gucio321/EspScope/case/EspScopeCaseV2.FCStd

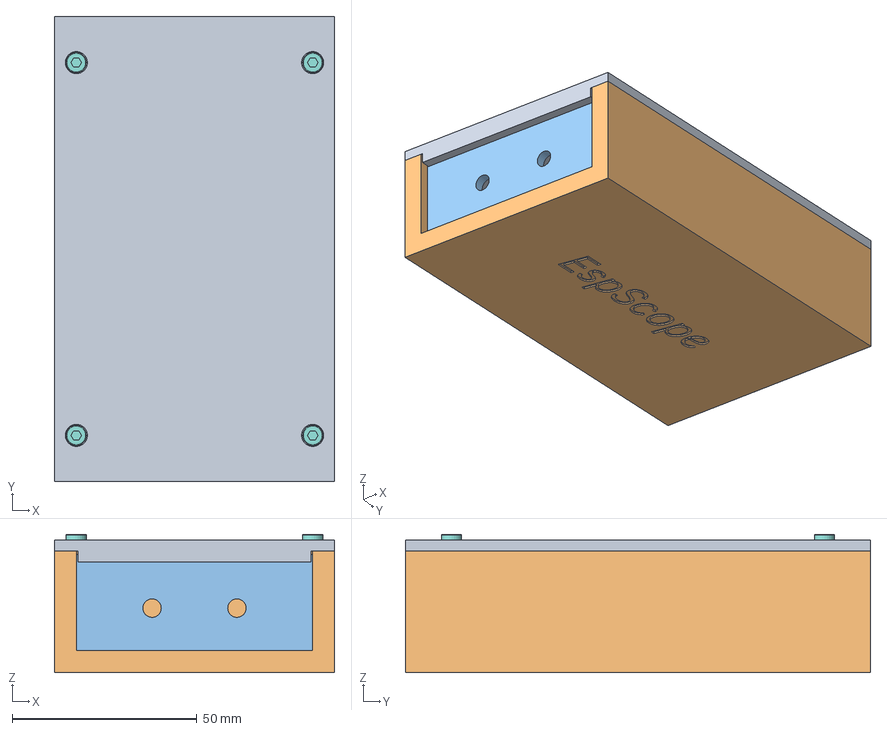
[picture p2: CAD file, 2026-10-28]
case/EspScopeCaseV2.FCStd
76.0 x 126.0 x 37.5 mm
BottomPlate
TopCover
Front
Back
Board~Emqj
TopSilkscreen~Emqj
TopSilkscreen~Emqj001
TopSilkscreen~Emqj002
TopSilkscreen~Emqj003
TopSilkscreen~Emqj004
TopSilkscreen~Emqj005
TopSilkscreen~Emqj006
TopSilkscreen~Emqj007
TopSilkscreen~Emqj008
TopSilkscreen~Emqj009
TopSilkscreen~Emqj010
TopSilkscreen~Emqj011
TopSilkscreen~Emqj012
TopSilkscreen~Emqj013
TopSilkscreen~Emqj014
TopSilkscreen~Emqj015
TopSilkscreen~Emqj016
TopSilkscreen~Emqj017
TopSilkscreen~Emqj018
TopSilkscreen~Emqj019
TopSilkscreen~Emqj020
TopSilkscreen~Emqj021
TopSilkscreen~Emqj022
TopSilkscreen~Emqj023
TopSilkscreen~Emqj024
TopSilkscreen~Emqj025
TopSilkscreen~Emqj026
TopSilkscreen~Emqj027
TopSilkscreen~Emqj028
TopSilkscreen~Emqj029
TopSilkscreen~Emqj030
TopSilkscreen~Emqj031
TopSilkscreen~Emqj032
TopSilkscreen~Emqj033
TopSilkscreen~Emqj034
TopSilkscreen~Emqj035
TopSilkscreen~Emqj036
TopSilkscreen~Emqj037
TopSilkscreen~Emqj038
TopSilkscreen~Emqj039
TopSilkscreen~Emqj040
TopSilkscreen~Emqj041
TopSilkscreen~Emqj042
TopSilkscreen~Emqj043
TopSilkscreen~Emqj044
TopSilkscreen~Emqj045
TopSilkscreen~Emqj046
TopSilkscreen~Emqj047
TopSilkscreen~Emqj048
TopSilkscreen~Emqj049
TopSilkscreen~Emqj050
TopSilkscreen~Emqj051
TopSilkscreen~Emqj052
TopSilkscreen~Emqj053
TopSilkscreen~Emqj054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
