gucio321/EspScope/case/EspScope.FCStd

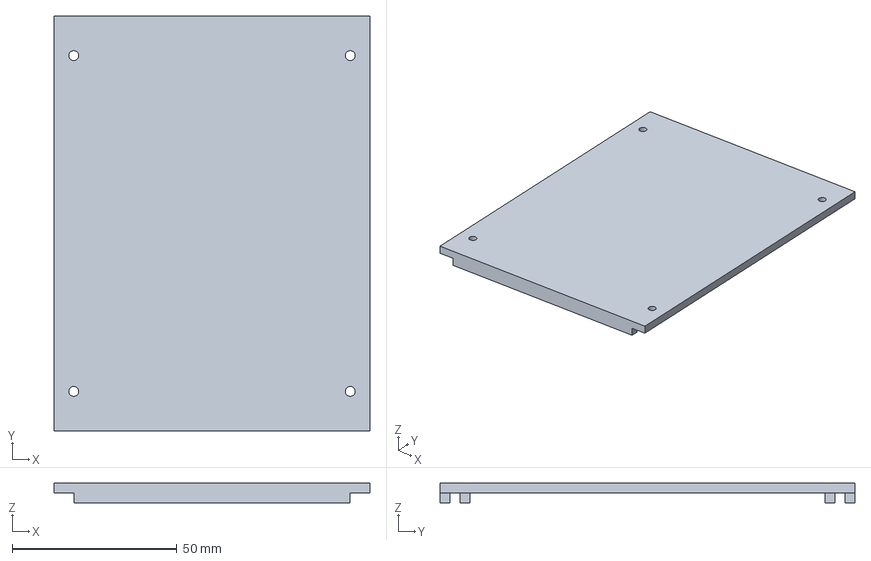
[picture p3: CAD file, 2026-06-23]
case/EspScope.FCStd
96.0 x 126.0 x 6.00 mm
