gucio321/EspScope/PCB/EspScope_schematic.pdf

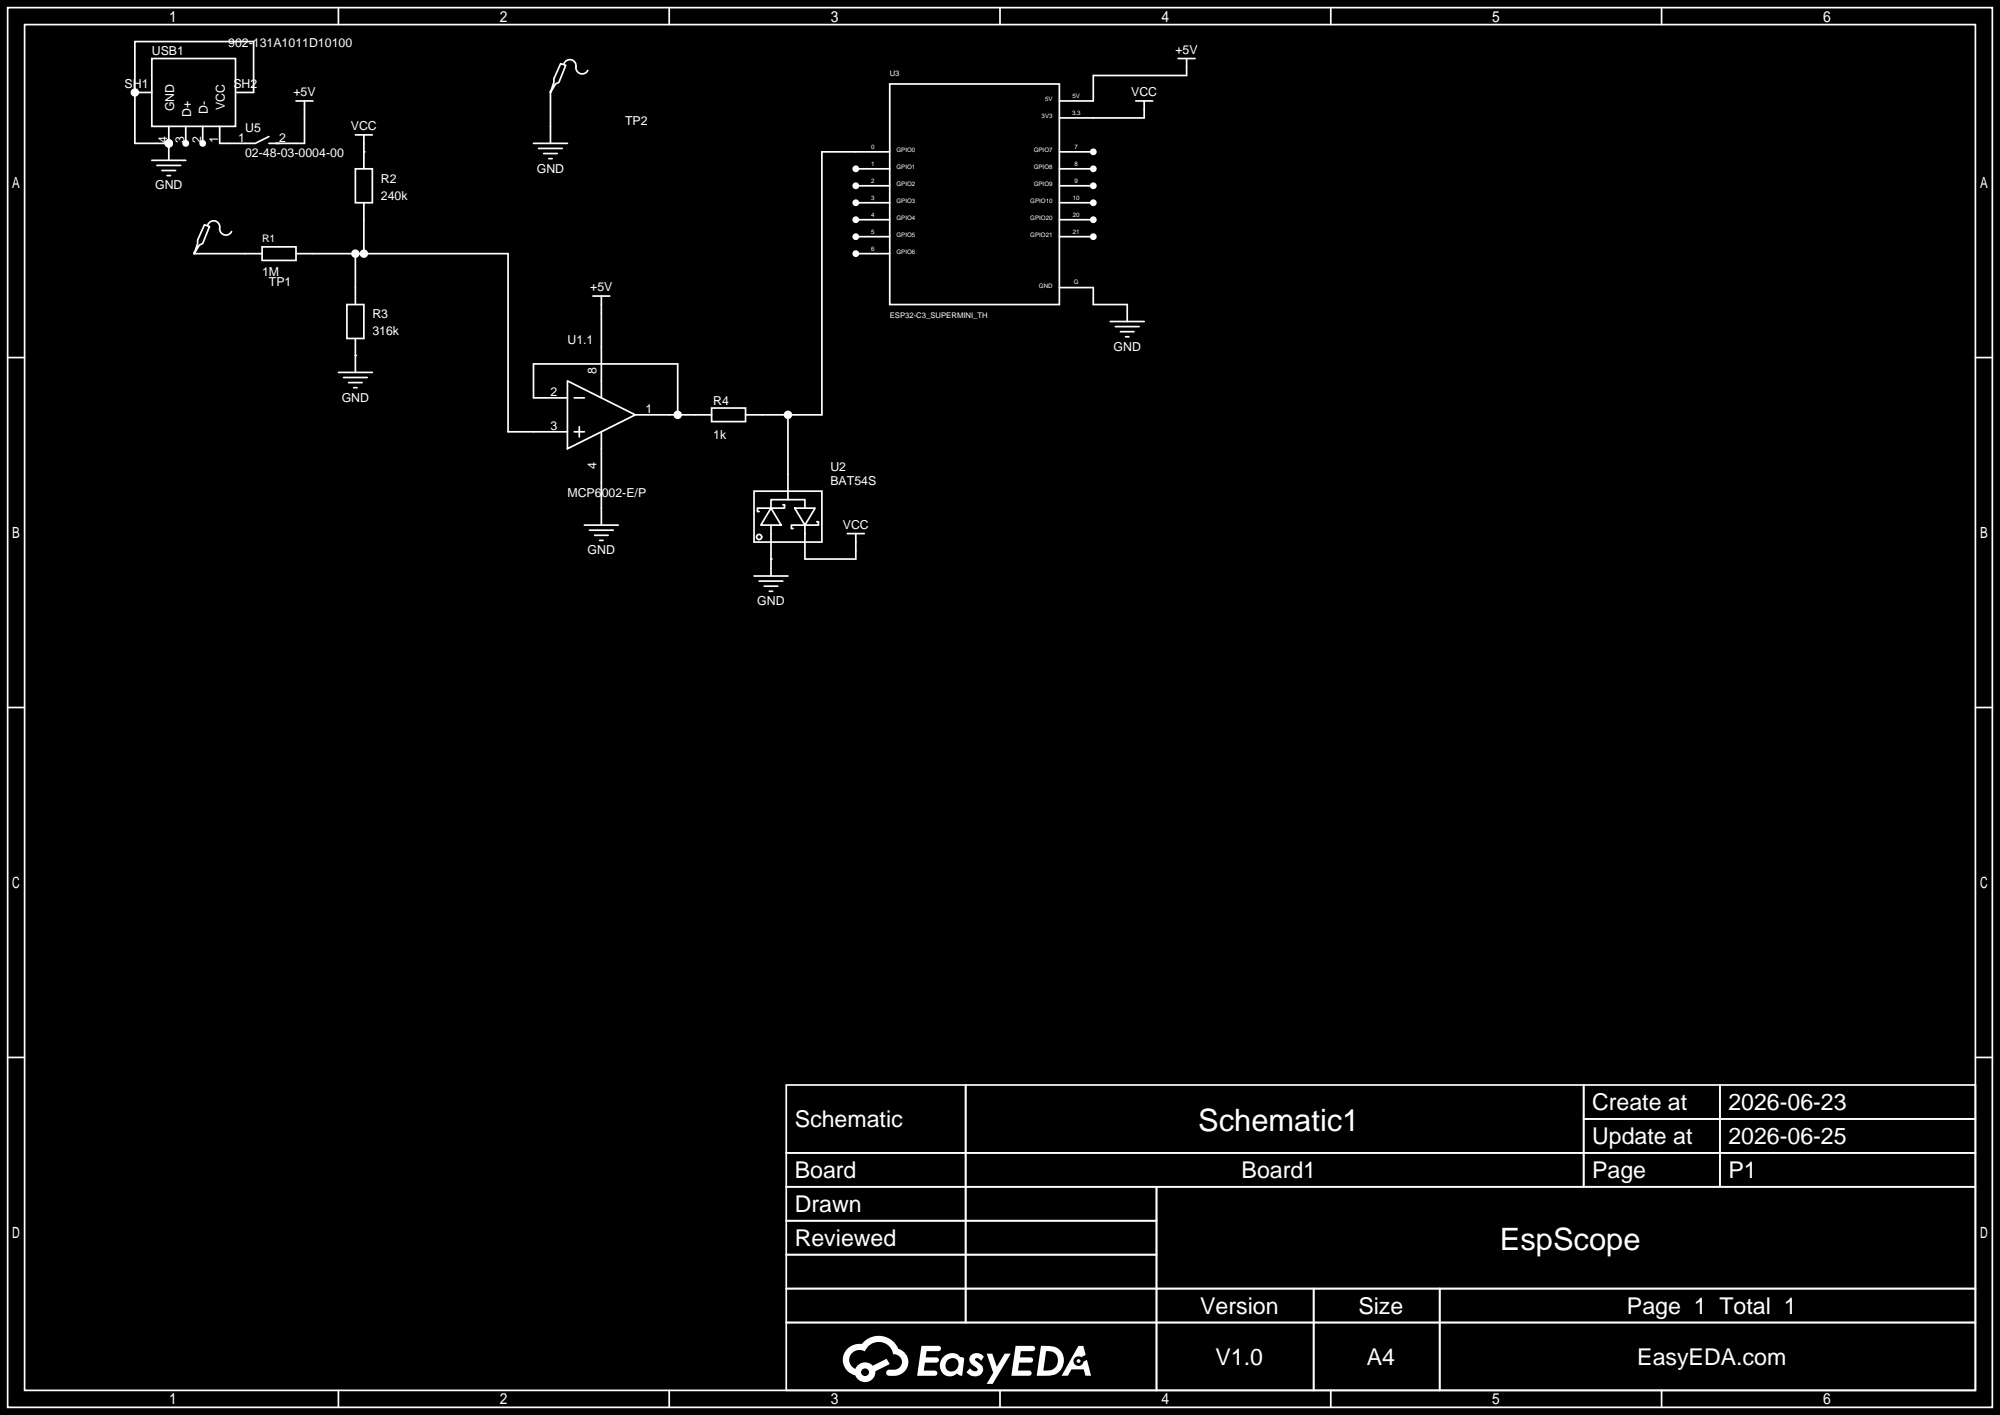
[picture p4: page 1]

Schematic | Schematic1 | Create at | 2026-06-23

Update at | 2026-06-25

Board | Board1 | Page | P1
Drawn | | EspScope
Reviewed

Version | Size | Page 1 Total 1
V1.0 | A4 | EasyEDA.com
