gucio321/EspScope/PCB/EspScope_layout.pdf

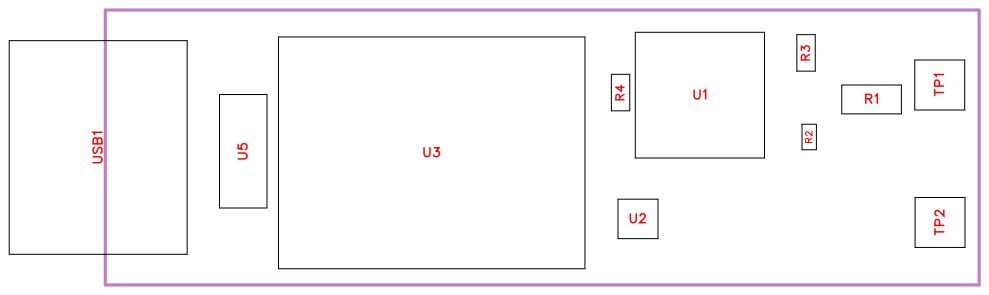
[picture p5: page 1]

No. | Quantity | Comment | Designator | Footprint | Value | Manufacturer Part | Manufacturer | Supplier Part | Supplier
1 | 1 | 1M | R1 | R1206 | 1M | RT1206BRD 071ML | YAGEO(国巨 ) | C309662 | LCSC
2 | 1 | 240k | R2 | R0402 | 240k | FRC0402F24 03TS | FOJAN(富捷 ) | C2909338 | LCSC
3 | 1 | 316k | R3 | R0603 | 316k | RT0603BRD 07316KL | YAGEO(国巨 ) | C861317 | LCSC
4 | 1 | 1k | R4 | R0603 | 1k | ARG03BTC1 001 | Viking(光颉 ) | C309080 | LCSC
5 | 2 | Test-Point | TP1,TP2 | Test-Point-0. 5mm
6 | 1 | MCP6002-E/ P | U1 | PDIP-8_L9.3-W6.4-P2.54-LS7.9-BL-1 | | MCP6002-E/ P | MICROCHIP( ) 美国微芯 | C640393 | LCSC
7 | 1 | BAT54S | U2 | SOT-23-3_L2 .9-W1.3-P1.9 0-LS2.4-BR | | BAT54S | DOWO(东沃 ) | C22374724 | LCSC
8 | 1 | ESP32-C3_S UPERMINI_T H | U3 | MODULE_E SP32-C3_SU PERMINI_TH | ESP32-C3_S UPERMINI_T H
9 | 1 | 02-48-03-000 4-00 | U5 | KEY-SMD_L 6.0-W3.5-LS 8.0-1 | | 02-48-03-000 4-00 | | C990001440 7 | LCSC
10 | 1 | 902-131A101 1D10100 | USB1 | USB-A-TH__ USB-AF-90 | | 902-131A101 1D10100 | 精拓金 | C2345 | LCSC

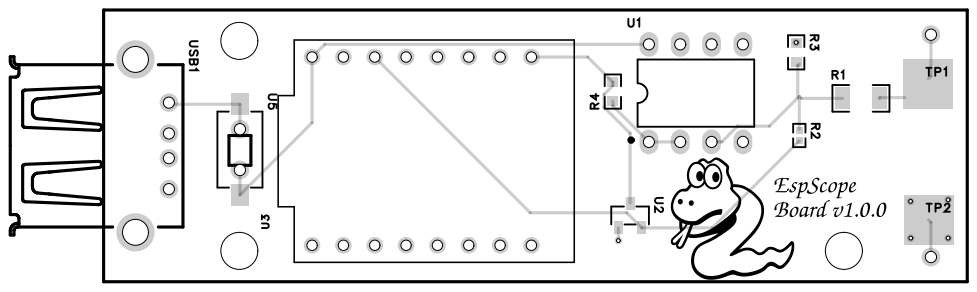
[picture p6: page 4]

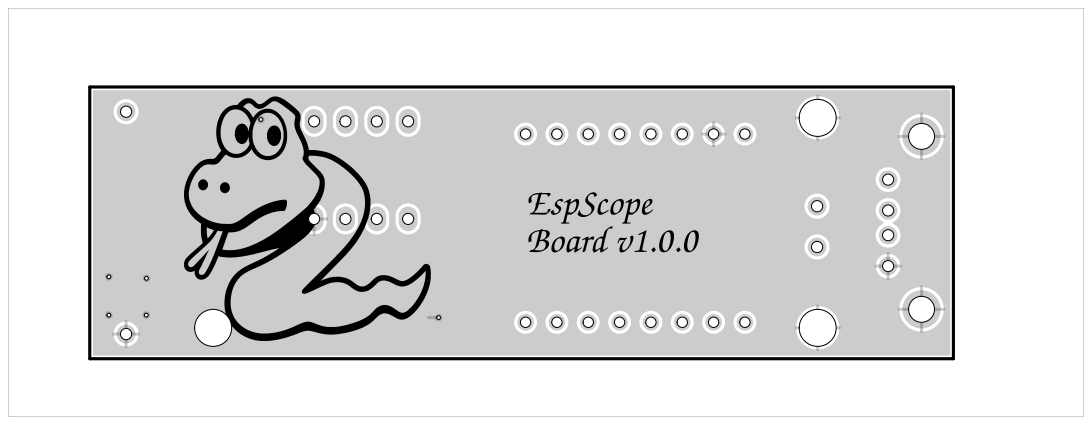
[picture p7: page 5]

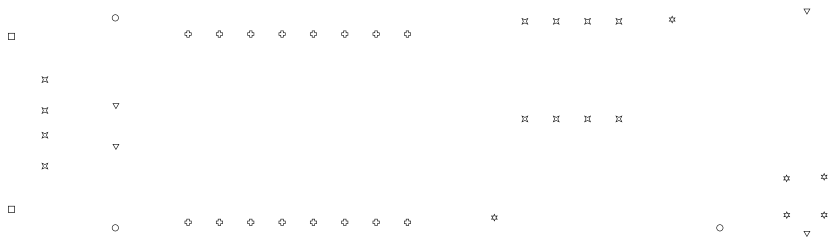
[picture p8: page 6]
