gucio321/EspScope/(commit log)

2026-06-22 add plot and sample rate setup
2026-06-23 gui: add 1st stage calibration
2026-06-23 firmware: support auto-calibration
2026-06-23 case: add freecad project
    [EspScope.FCStd]
2026-06-23 gui: add voltage scale calibration
2026-06-23 gui: consider adc table while receiving data
2026-06-23 gui: add appropiate log while updating voltage multiplier
2026-06-24 fix(espmanager): fix crash when scope was streaming while not connected
    No nil pointer dereference panic should happen now.
    Also, fixed possible issues when adc value overflows lookup table len (theoritical index out of bound panic)
    Now the code pre-checks if the adc value is greater than cached table
    length.
2026-06-24 gui: move calibration to the file menu
2026-06-25 feat: display average voltage, fix critical issues in calibration
2026-07-08 feat(gui): show current value on the crosshairs
2026-07-09 gui: move calibration dialog into a separate file
    also redesign it a bit
2026-07-09 gui: move calibrationPopupID constant deffinition
2026-07-09 feat(firmware): unfreez constant sampling rate
    now sampling rate could be changed by re-initializing continuous ADC
2026-07-09 feat(firmware): allow to set sample rate
2026-07-09 rename: sampleRate => samplesPerFrame
2026-07-09 feat(gui): add samples per frame rescaling feature
    fix #4
2026-07-10 case: add v2 case with board v1 support
    [EspScopeCaseV2.FCStd]
2026-07-11 case: update junctions placement and add project name
    [EspScopeCaseV2.FCStd]
2026-07-13 case: fix dimensions
    banana slot should be 5mm instead of 3mm
    tolerance (after printing) is too big
    [EspScopeCaseV2.FCStd]
2026-10-28 case/v2: add screws and the board
    [EspScopeCaseV2.FCStd]
2026-10-28 PCB: add schematic
2026-10-28 PCB: add pcb layout specification PDF
2026-10-28 pcb: convert schematic to svg
2026-10-28 Revert "pcb: convert schematic to svg"
    This reverts commit e43d9a8b61312544f336fb2cbaafc9b9be0c2f08.
2026-10-28 readme: add bom
